Twinkle12345239/Smart-collar/README.md

# -
以高原地区牦牛养殖为背景，设计一种在无网环境下检测牦牛位置和运动状态的系统设备
